kquann/FBV_MIDI/Resources/Photos/Interface_4.jpg

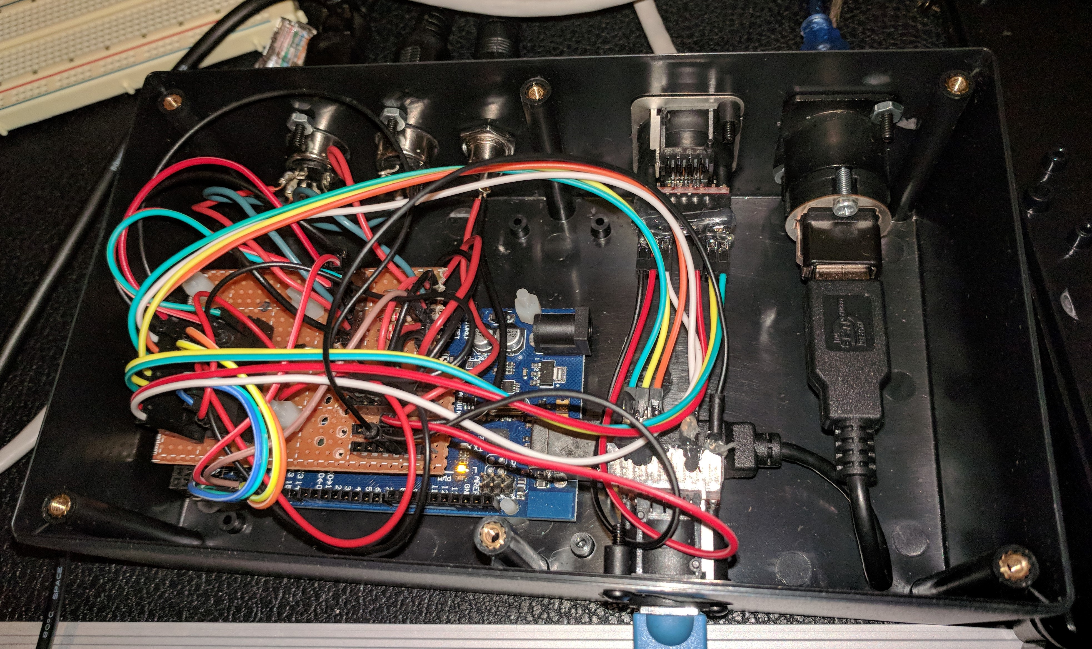
Resources/Photos/Interface_4.jpg
