kquann/FBV_MIDI/Resources/Photos/FBV_MkII.jpg

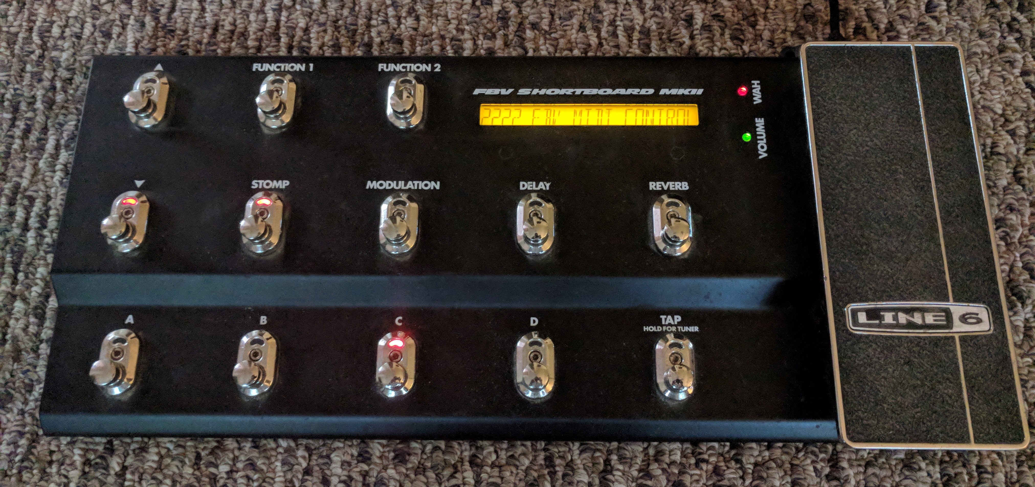
Resources/Photos/FBV_MkII.jpg
