kquann/FBV_MIDI/Resources/Photos/FBV3.jpg

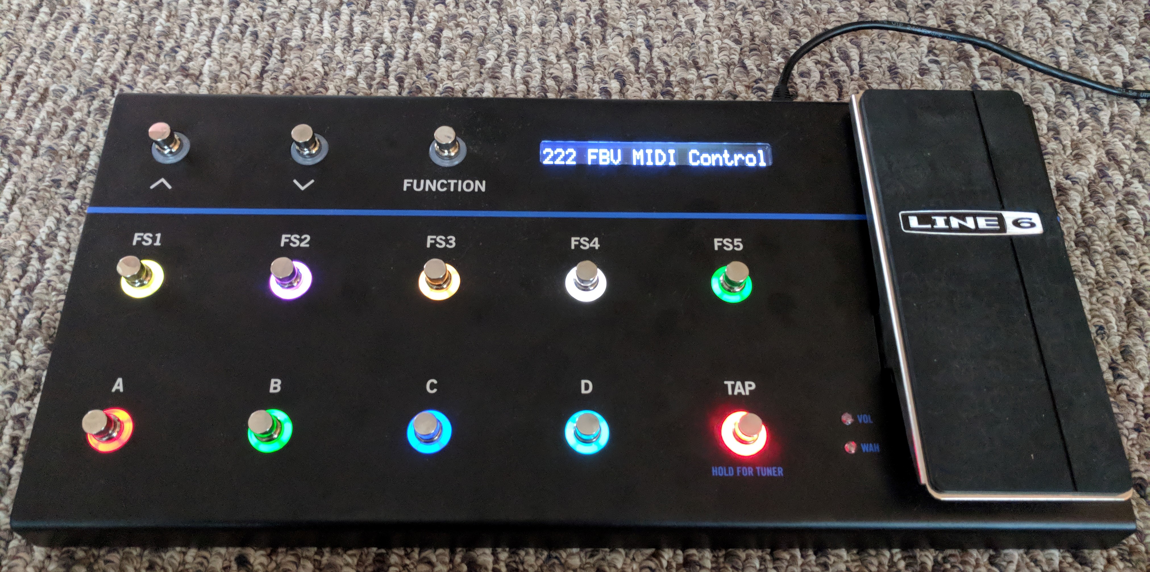
Resources/Photos/FBV3.jpg
