kquann/FBV_MIDI/Resources/Parts_list.xlsx

Part | Part # | Price | Quantity | Subtotal | Vendor | Link
Aruduino Mega | Elegoo-EL-CB-003 | $15.00 | 1 | $15.00 | Amazon | https://www.amazon.com/Elegoo-EL-CB-003-ATmega2560-ATMEGA16U2-Arduino/dp/B01H4ZLZLQ
Max-488 chip | 700-MAX488CPA | $2.64 | 2 | $5.28 | Mouser | https://www.mouser.com/ProductDetail/Maxim-Integrated/MAX488CPA%2b?qs=sGAEpiMZZMvbyeSUH4qH%2fPtxa3bcobQ2
Rasbperry Pi3 | Rasbberry Pi-3 Model B | $35.00 | 1 | $35.00 | Amazon | https://www.amazon.com/Raspberry-Pi-RASPBERRYPI3-MODB-1GB-Model-Motherboard/dp/B01CD5VC92?s=pc
SD Card 16gb | B073K14CVB | $8.50 | 1 | $8.50 | Amazon | https://www.amazon.com/Sandisk-Ultra-Micro-UHS-I-Adapter/dp/B073K14CVB?s=electronics
Raspberry Pi case | B01F1PSFY6 | $7.45 | 1 | $7.45 | Amazon | https://www.amazon.com/Official-Raspberry-Pi-Case-Black/dp/B01F1PSFY6?s=electronics
Micro USB cable | 7A82V4 | $4.89 | 1 | $4.89 | Amazon | https://www.amazon.com/AmazonBasics-Male-Micro-Cable-Black/dp/B0711PVX6Z?s=electronics
Ethernet Jack | NE8FDV | $5.68 | 2 | $11.36 | Mouser | https://www.mouser.com/ProductDetail/Neutrik/NE8FDV-B
RJ45 breakout | BOB-00716 | $0.95 | 2 | $1.90 | Mouser | https://www.mouser.com/ProductDetail/SparkFun/BOB-00716?qs=sGAEpiMZZMuWWq7rhECaKZgXZ5fqR1B3XqOlymLl8m0%3d
Female header | B00CFENE02 | $7.95 | 1 | $7.95 | Amazon | https://www.amazon.com/SUNKEE-2-54mm-Single-Straight-Ardunio/dp/B00CFENE02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
Ribbon jumper cable | B00KOL8O6C | $4.99 | 1 | $4.99 | Amazon | https://www.amazon.com/gp/product/B00KOL8O6C/ref=ox_sc_act_title_1?smid=A3UJU66UCNEADW&psc=1
6 inch USB cable | B079ZP65SN | $5.89 | 1 | $5.89 | Amazon | https://www.amazon.com/inch-USB-2-0-Male-Cable/dp/B079ZP65SN?dpID=41MvFEmGWfL&preST=_SY300_QL70_&dpSrc=srch
USB B-A feedthrough | 568-NAUSB-WB | $6.58 | 1 | $6.58 | Mouser | https://www.mouser.com/ProductDetail/568-NAUSB-W-B
DC jack -5 pack | B07C46XMPT | $7.99 | 1 | $7.99 | Amazon | https://www.amazon.com/outstanding-5-Pack-Threaded-Connector-Adapter/dp/B07C46XMPT?s=electronics
Power Supply | B074FT2LXD | $13.58 | 1 | $13.58 | Amazon | https://www.amazon.com/gp/product/B074FT2LXD/ref=ox_sc_act_title_2?smid=A29Z9539MHI3PX&psc=1
Enclosure | 1591XXEBK | $12.10 | 1 | $12.10 | Amazon | https://www.amazon.com/gp/product/B00HKIXNGI/ref=ox_sc_act_title_3?smid=AM88WW36I9TL9&psc=1
MIDI Jack | 502-57GB5FX | $3.12 | 2 | $6.24 | Mouser | http://www.mouser.com/ProductDetail/Switchcraft/57GB5FX/
1N4001 Diode | 512-1N4001 | $0.16 | 1 | $0.16 | Mouser | http://www.mouser.com/ProductDetail/Fairchild-Semiconductor/1N4001/?qs=sGAEpiMZZMuQUXCJI7Y4livqf9H1GTKY
Pack of 5 Prototype Universal Stripboard 2"x5" (50Ã—127mm) 1000hole Phenolic Pitch 0.1" | B00D29X6JS | $6.75 | 1 | $6.75 | Amazon | http://www.amazon.com/Prototype-Universal-Stripboard-50%C3%97127mm-1000hole/dp/B00D23G21S
3.3K resistor | 291-3.3K-RC | $0.10 | 1 | $0.10 | Mouser | http://www.mouser.com/Search/ProductDetail.aspx?R=291-3.3K-RCvirtualkey21980000virtualkey291-3.3K-RC
1M resistor | 291-1M-RC | $0.10 | 1 | $0.10 | Mouser | http://www.mouser.com/ProductDetail/Xicon/291-1M-RC/?qs=sGAEpiMZZMu61qfTUdNhGzJEQZpR5iQqSPJoNLxrDWs%3d
220 ohm resistor | 291-220-RC | $0.10 | 3 | $0.30 | Mouser | http://www.mouser.com/Search/ProductDetail.aspx?R=291-220-RCvirtualkey21980000virtualkey291-220-RC
100 Pcs Hex Threaded Spacer Offwhite Plastic PC Board Standoff | B0087Y9FTS | $5.90 | 1 | $5.90 | Amazon | http://www.amazon.com/Threaded-Spacer-Offwhite-Plastic-Standoff/dp/B0087Y9FTS
4-40 Nuts | B001B2QP3C | $5.17 | 1 | $5.17 | Amazon | https://www.amazon.com/Hillman-140009-Machine-Screw-100-Pack/dp/B001B2QP3C?s=industrial
4-40 Screws | B00F34V2ZA | $3.17 | 1 | $3.17 | Amazon | https://www.amazon.com/Machine-Finish-B18-6-3-Phillips-Threaded/dp/B00F34V2ZA
Consumables:
Hook-up wire
Solder
