kquann/FBV_MIDI/(threads)

Thread 1 (2020-04-30):

Support for the FBV EXPRESS MKII?

Andreas-T, 2020-04-30:
Hi.
Very interesting project. Thank you for sharing.
I wonder if the RJ-45 protocol used in these controllers is the same as in the FBV EXPRESS MKII?
Specifically I am looking to repurpose the Express to be able to send custom Sysex strings to a Roland keyboard by toggling a footswitch (4 message string, 68 bytes total for each switch state). If I could add MIDI out functionality to the Express also it would be great (to avoid having to use a USB Host/MIDI Out converter).
Thoughts?
Thanks for your time.

kquann, 2020-08-11:
Sorry for the late response. The Sysex protocol should be the same for the Express MkII, just with fewer buttons, though I have not tried it to confirm. The Python script could be easily modified to send a Sysex message

Closed 2022-03-21.

Thread 2 (2021-06-28):

Fbv3 + Raspberry + Boss Katana

Rob-C89, 2021-06-28:
Hi, I was wondering if it was possible to adapt your work to connect the FBV3 to a Boss Katana using just a Raspberry Pi, therefore using only usb and not the Rj45. Do you think it will be possible?

kquann, 2022-03-21:
Hi sorry for the late response. You could use an FBV connected directly over USB for that purpose as described here:
https://www.reddit.com/r/BossKatana/comments/msd597/controlling_the_katana_with_a_midi_controller/

However, MIDI implementation will be somewhat limited. This project (FBV_MIDI) sets out to make the FBV a more robust MIDI controller, though requires the use of the Arduino Sysex handler. Most likely, this will be more than you need if you are just looking to just control your Katana.

Thread 3 (2022-11-06):

Question regarding serial coms to FBV

toby11, 2022-11-06:
Great project - really interesting work so far.

I also have some custom windows software I use for midi control but thinking of allowing it to connect to my FBV mk2 (although thinking about getting a FBV 3 soon)

I am hoping to connect to it direct from the PC (so I dont need the ardunio and rasppi)

Is there anything special about the serial coms - do you think I could just a standard PC USB-Serial converter or would I need one specifically to connect to RS422/RS485, found some on amazon such as "USB to RS422 RS485 Serial Port Converter Adapter"

thanks!

toby11, 2022-11-08:
To answer my own question I purchased a USB to RS422 adapter and have connected it to my FBV Express Mk2 and I have got events coming through and they seem to be in the same main format as the FBV shortboard, I can get button press events and turn the leds on and off ok from my c# code.

Only issue I had was getting the TX+/- and RX+/- the correct way around and it appears to be backwards to whats labelled on my adapter.

thanks again for your work on this project - great job!

Closed 2022-11-08.

Thread 4 (2023-03-18):

python only code?

redkurn, 2023-03-18:
would it be possible to run this on python directly, using macos and logic to run helix native and would love to use this directly.

i could get a arduino, but hoping this could be simplified.

sorry for using a issue, but only means i can see of contacting you directly.
