kquann/FBV_MIDI/Resources/FBV_MIDI_schematic.pdf

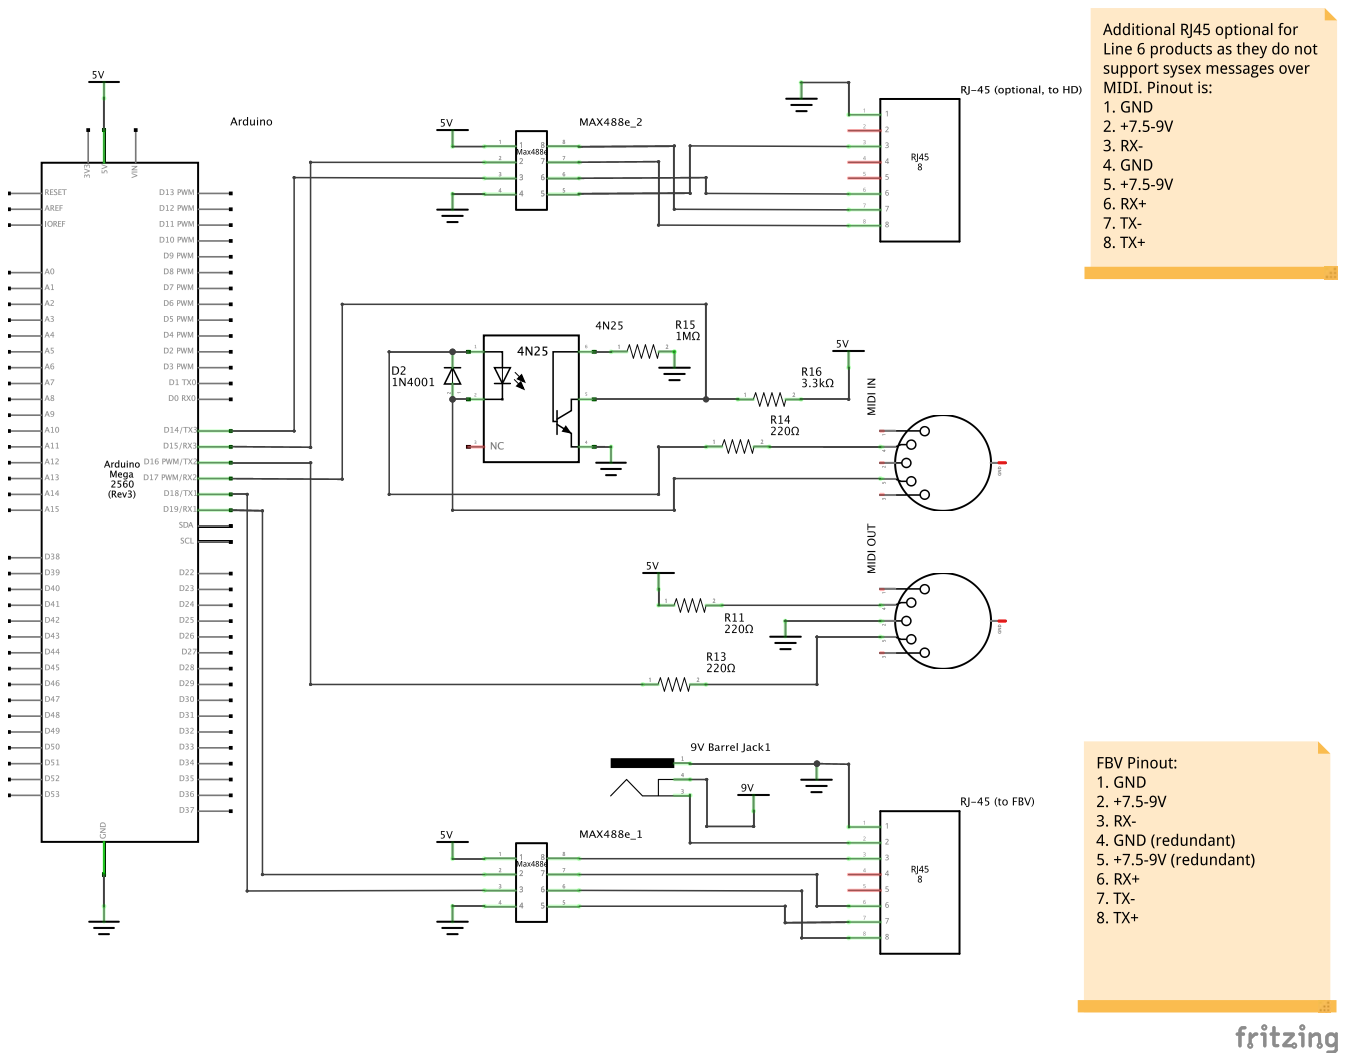
[picture p11: page 1]
