kquann/FBV_MIDI/(list of files, drawings)

Other design files:
Resources/FBV_MIDI_schematic.fzz
